R3D347HR4Y/retropilot-column-steering/README.md

# retropilot-column-steering
A repo containing 3D Models, code and info to retrofit a motor on the steering columns of Hydraulic Power Steering cars to interface with OpenPilot
