R3D347HR4Y/retropilot-column-steering/3DModels/README.md

# This folder contains all 3D models in Solidworks and 3D printable formats

The HTD 5M pulleys and adapters are designed to be bolted on a 00-04 Ford Focus/Fiesta steering column just before the rack.

You can modify the files to create versions that fit your own steering column (works best on keyholed or slotted columns)

<h2> There are 2 varieties of the pulley: </h1>
<h3>Clip version:</h3>
Hardware:

Quantity | Item | Link
:-:|:--|:--:
6 | 5mm dia 45mm long steel rods as axial reinforcements | None yet
4 | 3mm dia 20mm long steel rods as alignement and reinforcements | None yet
2 | Steel clable brackets for tightening | None yet

Print settings:
```
Infill 70% or higher
Material: ASA, PETG, ABS or PC
Perimeters: 3
Minimal to no print cooling
Supports everywhere
```
<h3>Bolt version:</h3>
Hardware:

Quantity | Item | Link
:-:|:--|:--:
2 | 25mm M5 Machine screws | None yet
2 | M5 Nuts | None yet

Print settings:
```
Infill 70% or higher
Material: ASA, PETG, ABS or PC
Perimeters: 3
Minimal to no print cooling
No supports
```
I have also included an adapter to fit a Toyota Steering angle sensor (2080 variant) on this column, it is possible that this could break your sensor so don't try this if you don't know what you're doing!

Are also included a bracket in two parts to attach a Nema 23 Stepper (1.85Nm variant) to the column, here's the BOM:

Hardware:

Quantity | Item | Link
:-:|:--|:--:
6 | 40mm M4 Machine screws | None yet
4 | 20mm M4 Machine screws | None yet
2 | M4 Nuts | None yet
4 | 624Z Bearings | https://fr.aliexpress.com/item/32819481156.html?gatewayAdapt=glo2fra&spm=a2g0o.9042311.0.0.27426c37nvxRWK
1 | 6806 Bearing | https://fr.aliexpress.com/item/1005003528637404.html?gatewayAdapt=glo2fra&spm=a2g0o.9042311.0.0.27426c375Ho3wr
2 | 6808 Bearing | https://fr.aliexpress.com/item/1005003528637404.html?gatewayAdapt=glo2fra&spm=a2g0o.9042311.0.0.27426c375Ho3wr
1 | 16mm wide HTD 5M 12T pulley 6.35mm | https://fr.aliexpress.com/item/32919310302.html?gatewayAdapt=glo2fra&spm=a2g0o.9042311.0.0.27426c375Ho3wr
1 | Nema 23 Stepper motor 2.8A | https://www.amazon.fr/gp/product/B00PNEPI0A/ref=ppx_yo_dt_b_asin_title_o01_s00?ie=UTF8&psc=1
1 | HTD 260-5M-15 Belt | https://fr.aliexpress.com/item/32919207375.html?spm=a2g0o.order_list.0.0.a2d65e5bfgOft8&gatewayAdapt=glo2fra

Print settings:
```
Infill 70% or higher
Material: ASA, PETG, ABS or PC
Perimeters: 3
Minimal to no print cooling
No supports
```

There's all kinds of other files including adapters which you can figure out and modify on your own, be aware the belt tighteners use 2 624Z bearings and a 20mm M4 Bold with the head chopped off (and bearings glued on)
These files have not been tested, it is a very early work in progress, use at your own risk!!
