R3D347HR4Y/retropilot-column-steering/3DModels/Renders/shot1.JPG

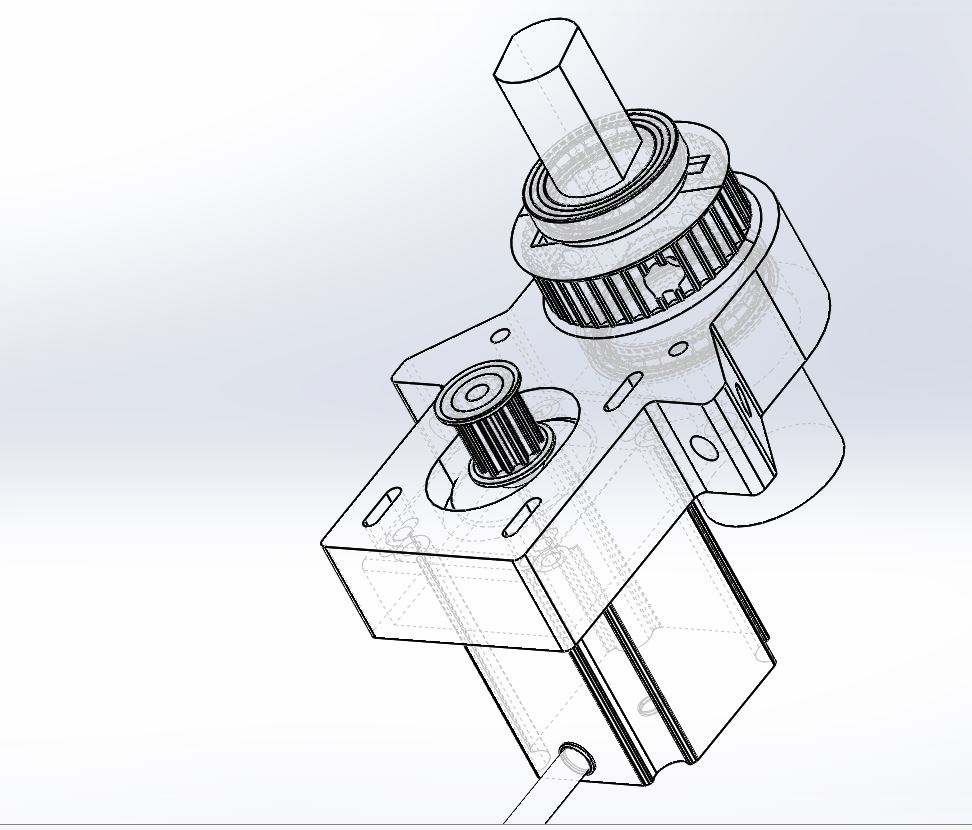
3DModels/Renders/shot1.JPG
