R3D347HR4Y/retropilot-column-steering/3DModels/Renders/shot5.JPG

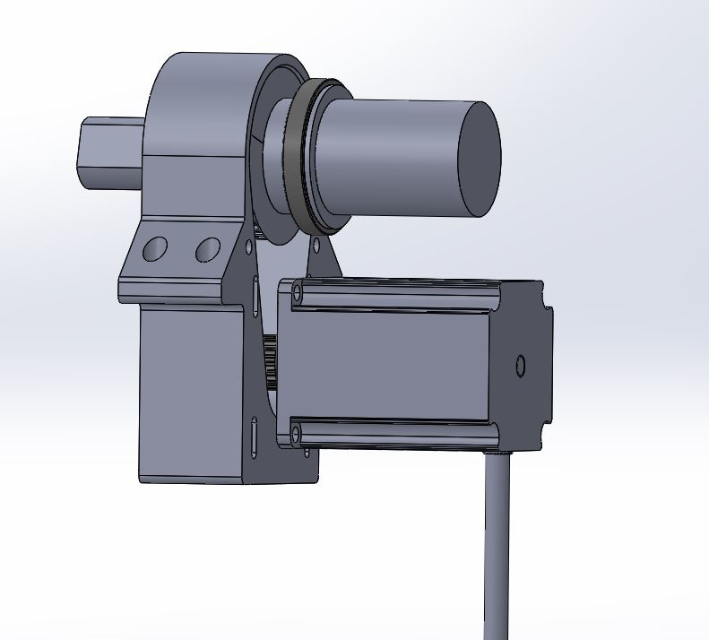
3DModels/Renders/shot5.JPG
