R3D347HR4Y/retropilot-column-steering/3DModels/Assemblage1.SLDASM

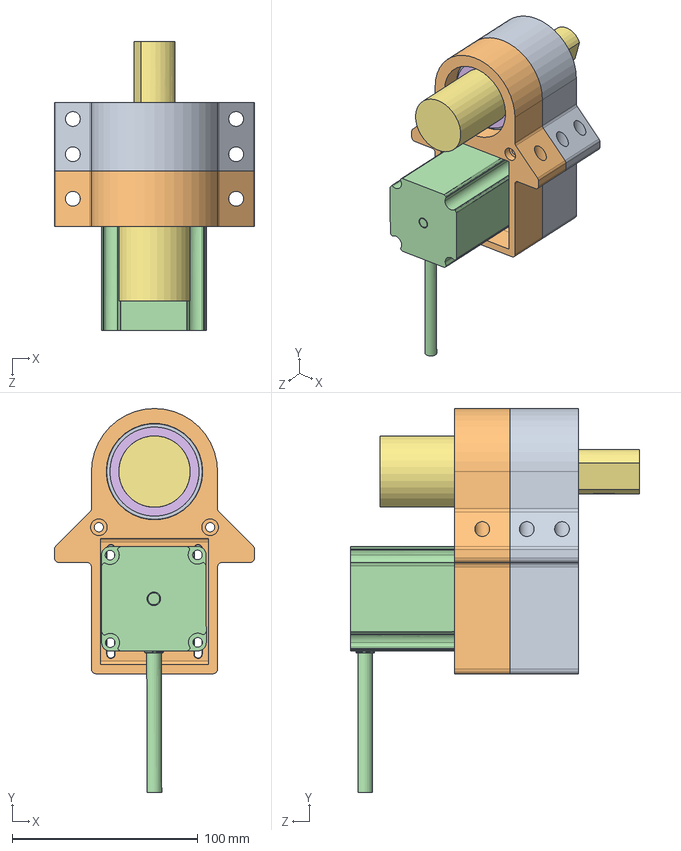
[picture p9: CAD file, 2022-07-21]
3DModels/Assemblage1.SLDASM
108.0 x 207.0 x 155.8 mm
Nema23ColumnHolderPart2V2
Nema23ColumnHolderv2
bearing_6806-2nse_01
bearing_6806-2nse_02
bearing_6806-2nse_03
bearing_6806-2nse_04
bearing_6806-2nse_05
bearing_6808nse_01
bearing_6808nse_02
bearing_6808nse_03
bearing_6808nse_04
stp-mtrac-23078
Bearing6806FordAdapter
Bearing6808FordAdapter
FordColumnPlaceholder
FordPulley36TBoltHTD5MSplit
a9-12-5m15_01
a9-12-5m15_02
a9-12-5m15_03
