R3D347HR4Y/retropilot-column-steering/3DModels/testNemaP1.3mf

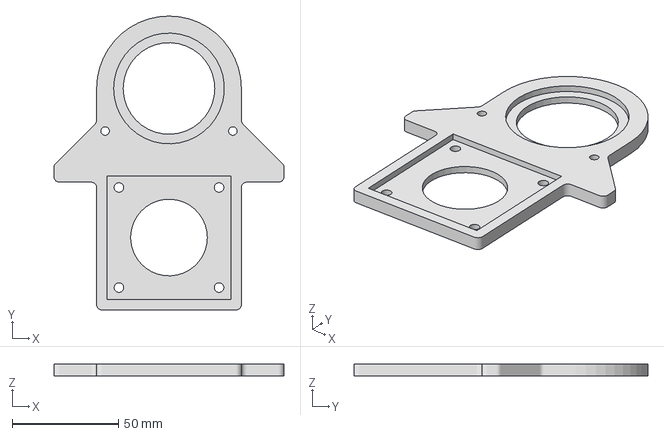
[picture p10: CAD file, 2022-07-21]
3DModels/testNemaP1.3mf
108.0 x 138.0 x 5.73 mm
