R3D347HR4Y/retropilot-column-steering/3DModels/Nema23ColumnHolderPart2V2.SLDPRT

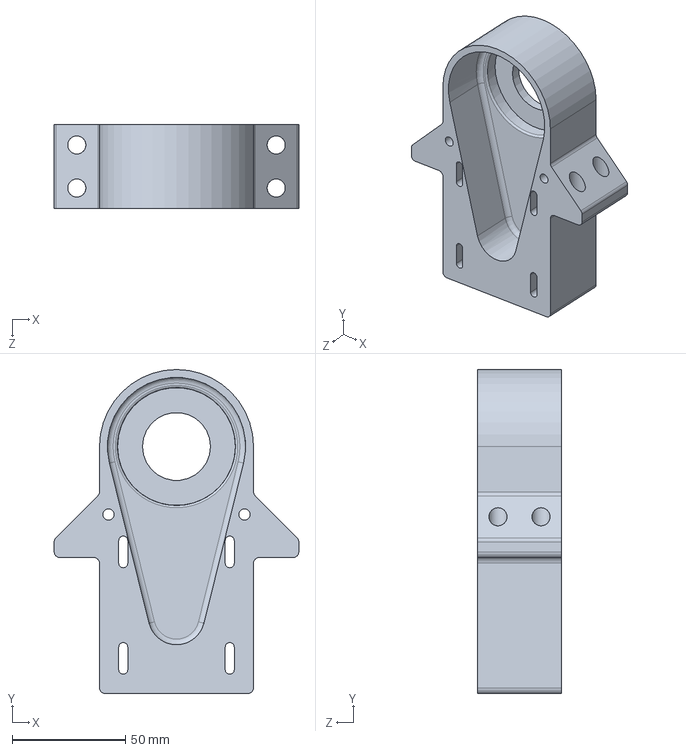
[picture p11: CAD file, 2022-07-21]
3DModels/Nema23ColumnHolderPart2V2.SLDPRT
108.0 x 143.0 x 37.0 mm
