R3D347HR4Y/retropilot-column-steering/3DModels/Nema23ColumnHolderv2.SLDPRT

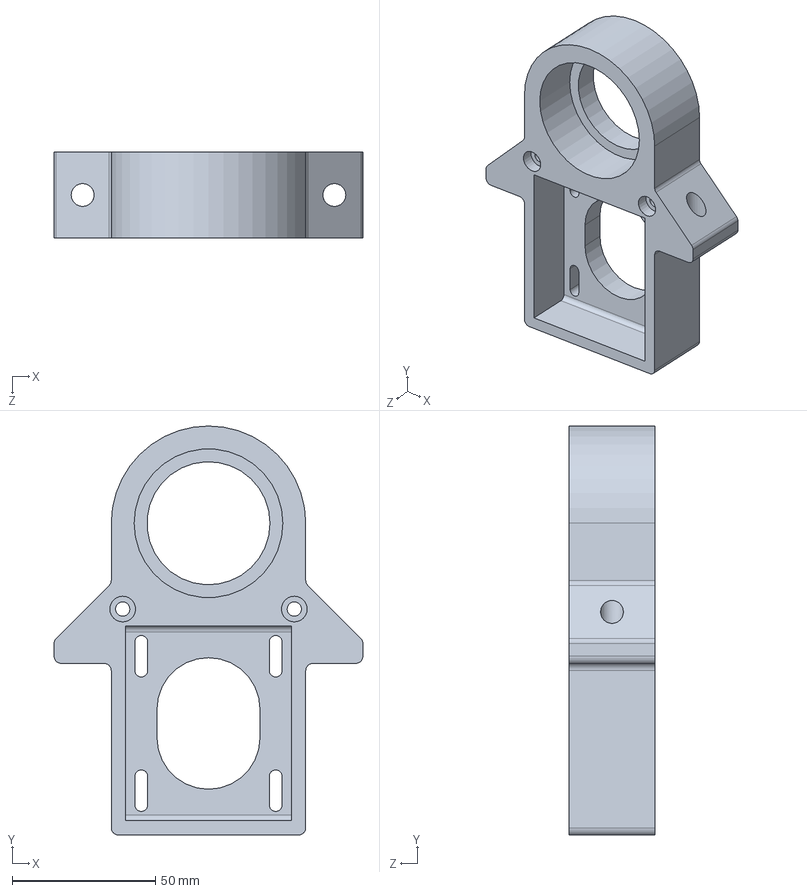
[picture p12: CAD file, 2022-07-21]
3DModels/Nema23ColumnHolderv2.SLDPRT
108.0 x 143.0 x 30.0 mm
