R3D347HR4Y/retropilot-column-steering/3DModels/FordColumnPlaceholder.SLDPRT

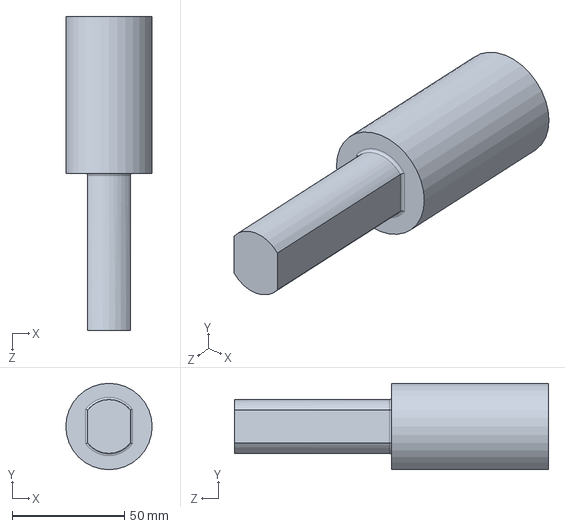
[picture p13: CAD file, 2022-07-21]
3DModels/FordColumnPlaceholder.SLDPRT
38.5 x 38.5 x 140.0 mm
