R3D347HR4Y/retropilot-column-steering/3DModels/Nema23ColumnHolderPart2.SLDPRT

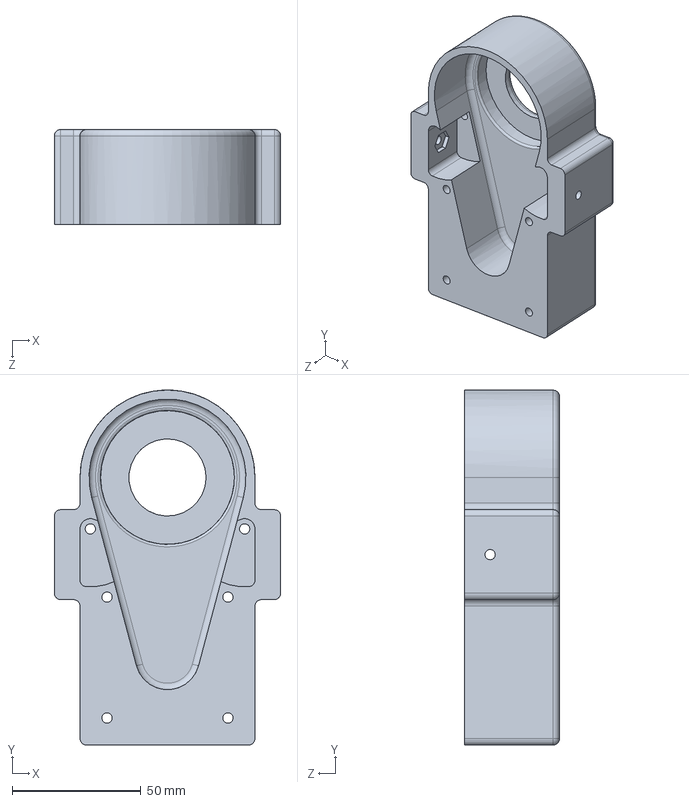
[picture p14: CAD file, 2022-02-22]
3DModels/Nema23ColumnHolderPart2.SLDPRT
88.0 x 138.0 x 37.0 mm
