R3D347HR4Y/retropilot-column-steering/3DModels/FordSteeringTSSAdapter.SLDPRT

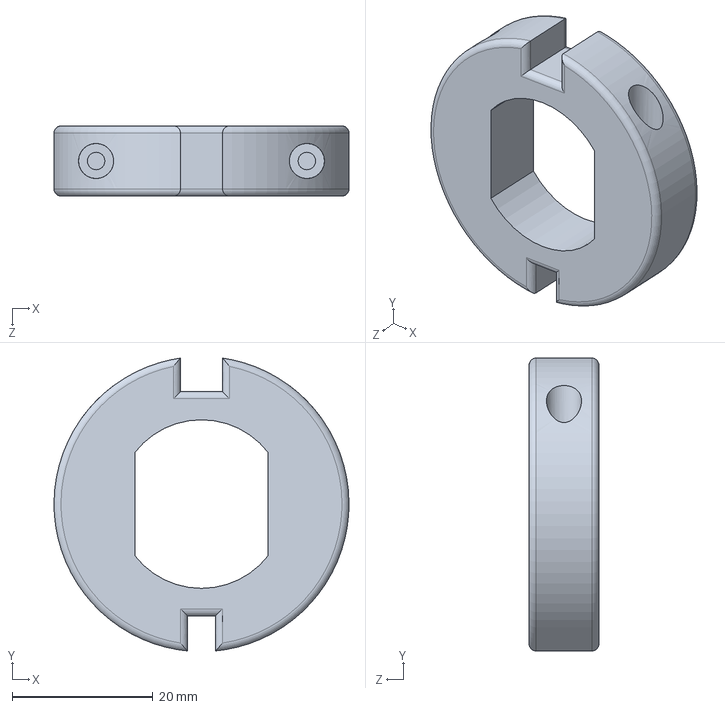
[picture p15: CAD file, 2022-02-22]
3DModels/FordSteeringTSSAdapter.SLDPRT
42.0 x 41.7 x 10.0 mm
