R3D347HR4Y/retropilot-column-steering/3DModels/FordPulley36TClipHTD5MSplit.3mf

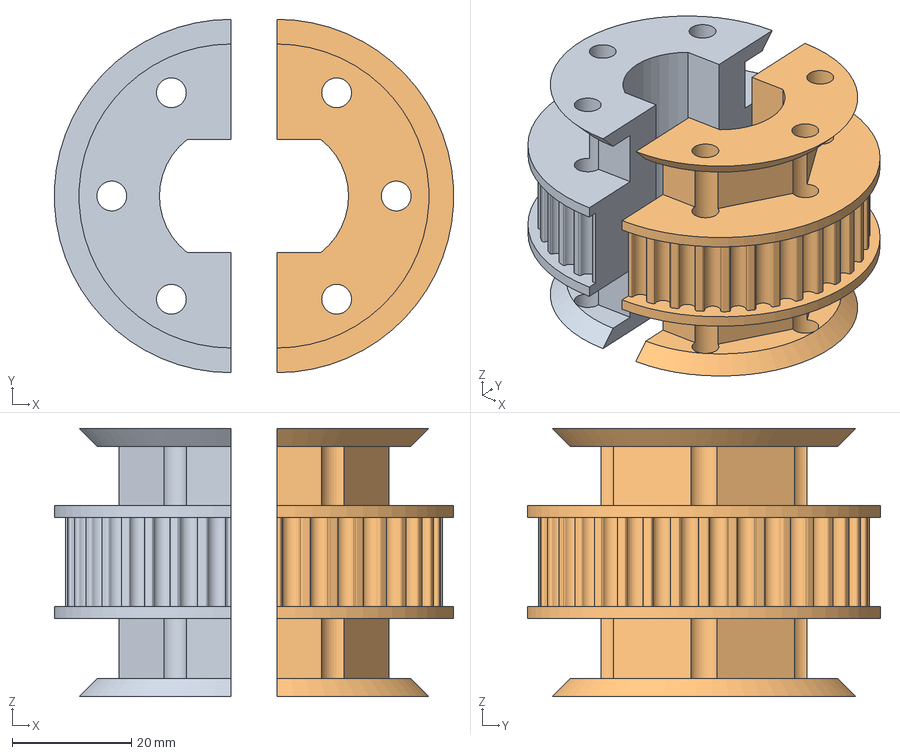
[picture p16: CAD file, 2022-02-22]
3DModels/FordPulley36TClipHTD5MSplit.3mf
67.0 x 59.3 x 45.0 mm
