R3D347HR4Y/retropilot-column-steering/3DModels/FordPulley36TClipHTD5M.SLDPRT

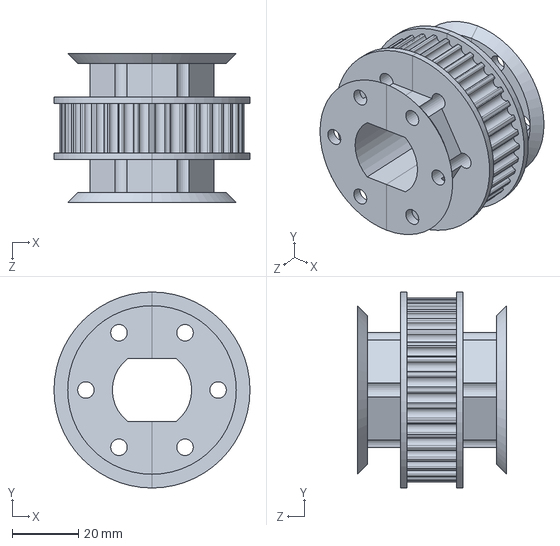
[picture p17: CAD file, 2022-02-22]
3DModels/FordPulley36TClipHTD5M.SLDPRT
59.3 x 59.3 x 45.0 mm
