R3D347HR4Y/retropilot-column-steering/3DModels/Bearing6806FordAdapterSplit.stl

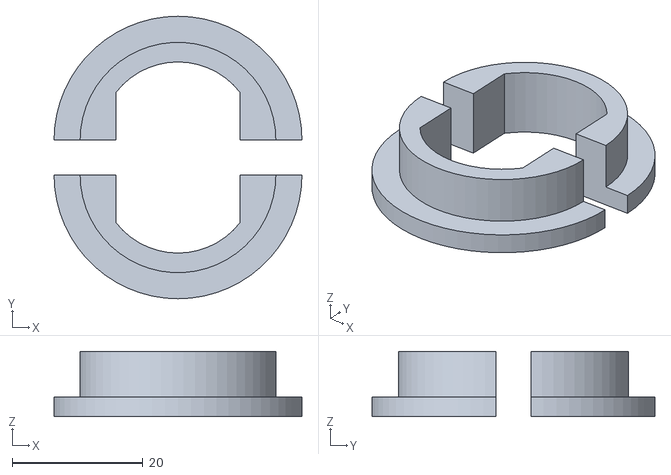
[picture p18: CAD file, 2022-02-22]
3DModels/Bearing6806FordAdapterSplit.stl
38.0 x 43.3 x 10.0
