R3D347HR4Y/retropilot-column-steering/3DModels/BeltTightenerV1.SLDPRT

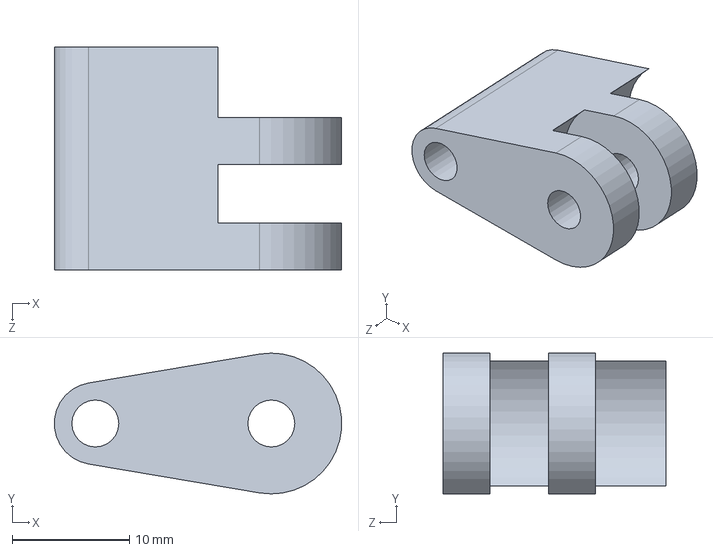
[picture p19: CAD file, 2022-02-22]
3DModels/BeltTightenerV1.SLDPRT
24.5 x 12.0 x 19.0 mm
