R3D347HR4Y/retropilot-column-steering/3DModels/Bearing6808FordAdapter.SLDPRT

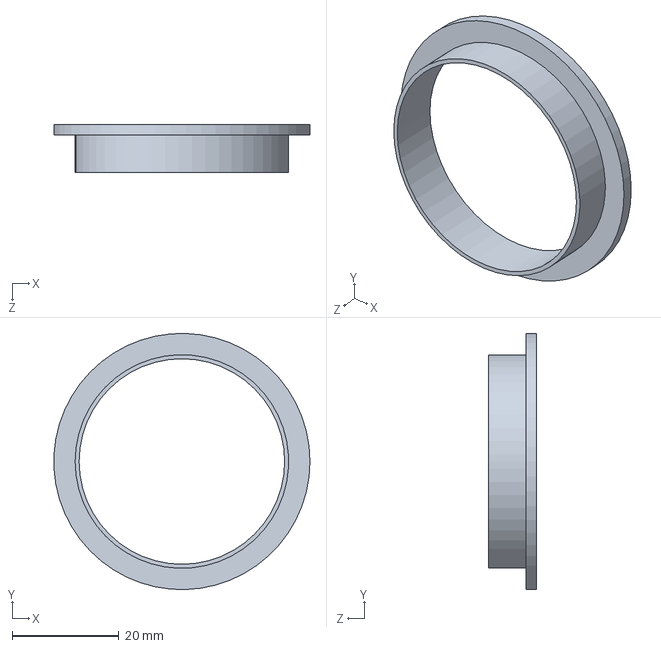
[picture p20: CAD file, 2022-02-22]
3DModels/Bearing6808FordAdapter.SLDPRT
48.0 x 48.0 x 9.00 mm
