R3D347HR4Y/retropilot-column-steering/3DModels/Bearing6806FordAdapter.SLDPRT

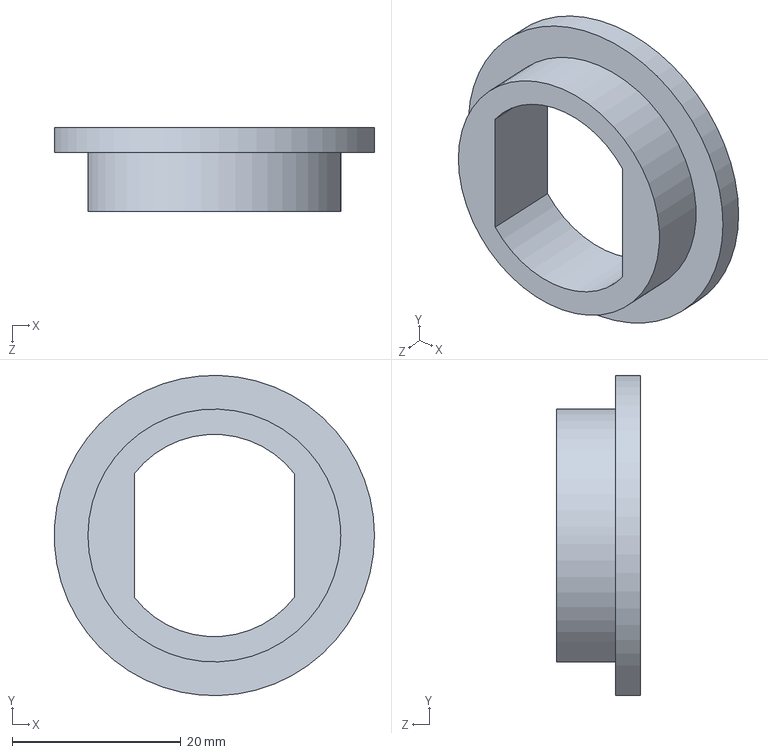
[picture p21: CAD file, 2022-02-22]
3DModels/Bearing6806FordAdapter.SLDPRT
38.0 x 38.0 x 10.0 mm
