R3D347HR4Y/retropilot-column-steering/3DModels/FordSteeringTSSAdapterSplit.stl

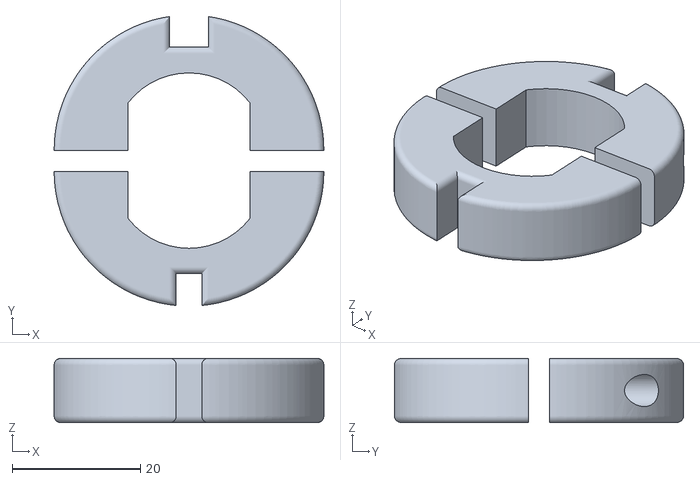
[picture p22: CAD file, 2022-02-22]
3DModels/FordSteeringTSSAdapterSplit.stl
42.0 x 45.0 x 10.0
