R3D347HR4Y/retropilot-column-steering/3DModels/FordPulley36TClipHTD5MHalf1.SLDPRT

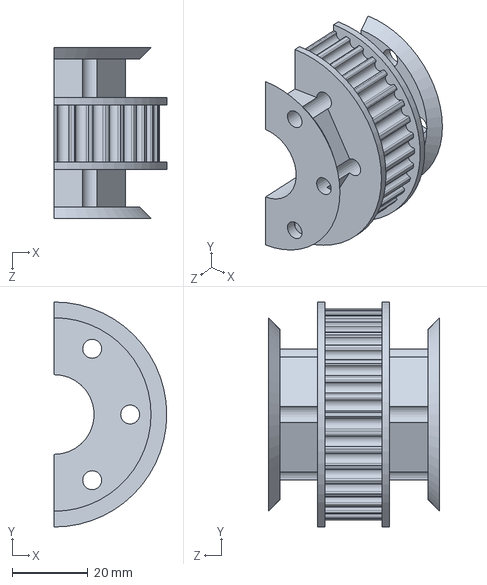
[picture p23: CAD file, 2022-02-10]
3DModels/FordPulley36TClipHTD5MHalf1.SLDPRT
29.6 x 59.3 x 45.0 mm
