R3D347HR4Y/retropilot-column-steering/3DModels/FordPulley36TBoltHTD5MSplit.SLDPRT

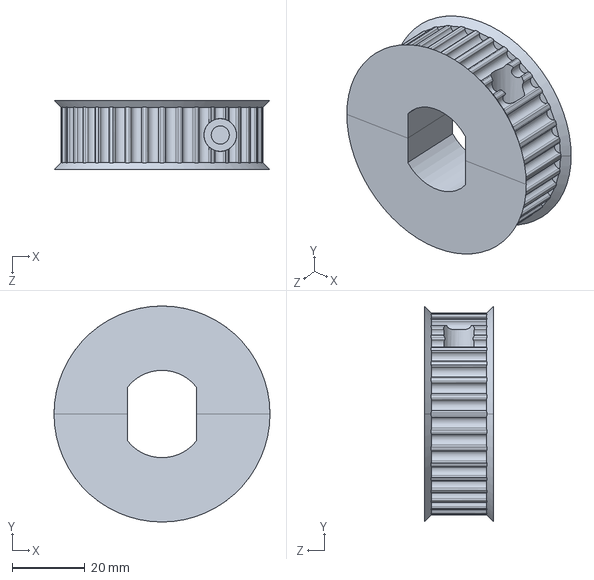
[picture p24: CAD file, 2022-02-22]
3DModels/FordPulley36TBoltHTD5MSplit.SLDPRT
59.3 x 59.3 x 19.0 mm
