R3D347HR4Y/retropilot-column-steering/(list of files, cad)

Other CAD files:
3DModels/Nema23ColumnHolder.SLDPRT
3DModels/FordPulley36TClipHTD5MHalf2.SLDPRT
3DModels/Bearing6808FordAdapter.STL
3DModels/BeltTightenerV1.STL
3DModels/FordPulley36TBoltHTD5MHalf1.SLDPRT
3DModels/FordPulley36TBoltHTD5MHalf2.SLDPRT
3DModels/FordPulley36TBoltHTD5MSplit.3mf
3DModels/FordPulley36TBoltHTD5MSplit.obj
3DModels/FordPulley36TClipHTD5M.STL
3DModels/Nema23ColumnHolder.STL
3DModels/Nema23ColumnHolderPart2.STL
3DModels/Nema23ColumnHolderPart2V2.STL
3DModels/Nema23ColumnHolderv2.STL
