R3D347HR4Y/retropilot-column-steering/(commit log)

2022-02-10 Sec commit
    [FordPulley36TBoltHTD5MHalf1.SLDPRT, FordPulley36TBoltHTD5MHalf2.SLDPRT, FordPulley36TBoltHTD5MSplit.SLDPRT, FordPulley36TBoltHTD5MSplit.obj, FordPulley36TClipHTD5M.SLDPRT, FordPulley36TClipHTD5MHalf1.SLDPRT, FordPulley36TClipHTD5MHalf2.SLDPRT, FordPulley36TClipHTD5MSplit.3mf]
2022-02-13 Fixed tss size
    [FordSteeringTSSAdapter.SLDPRT, FordSteeringTSSAdapterSplit.stl]
2022-02-22 Added brackets, changed from round to keyhole
    [Bearing6806FordAdapter.SLDPRT, Bearing6806FordAdapterSplit.stl, Bearing6808FordAdapter.SLDPRT, Bearing6808FordAdapter.STL, BeltTightenerV1.SLDPRT, BeltTightenerV1.STL, FordPulley36TBoltHTD5MSplit.3mf, FordPulley36TBoltHTD5MSplit.SLDPRT]
2022-07-21 Updated designs to be more simple, added assemblage and renders
    [Assemblage1.SLDASM, FordColumnPlaceholder.SLDPRT, Nema23ColumnHolder.SLDPRT, Nema23ColumnHolder.STL, Nema23ColumnHolderPart2V2.SLDPRT, Nema23ColumnHolderPart2V2.STL, Nema23ColumnHolderv2.SLDPRT, Nema23ColumnHolderv2.STL]
